msorair/bdkb40/case/keyboard_plate.stl

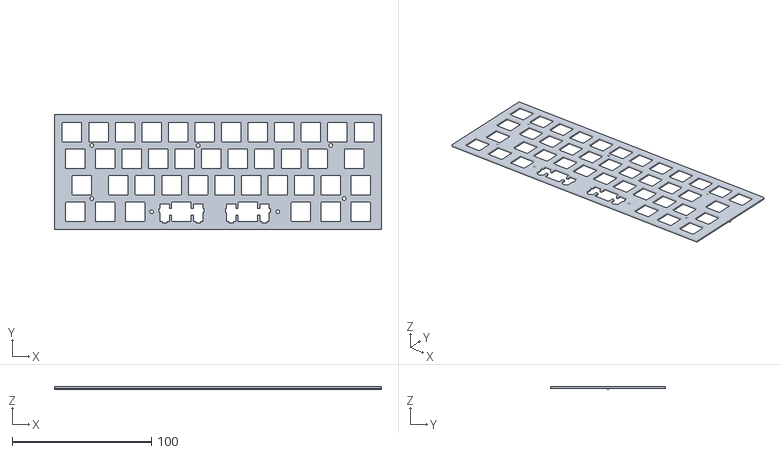
[picture p1: CAD file, 2026-01-17]
case/keyboard_plate.stl
234.6 x 82.2 x 2.50
