msorair/bdkb40/hardware/bdkb40.kicad_pcb

## KiCad design hardware/bdkb40.kicad_pcb (2026-03-20)

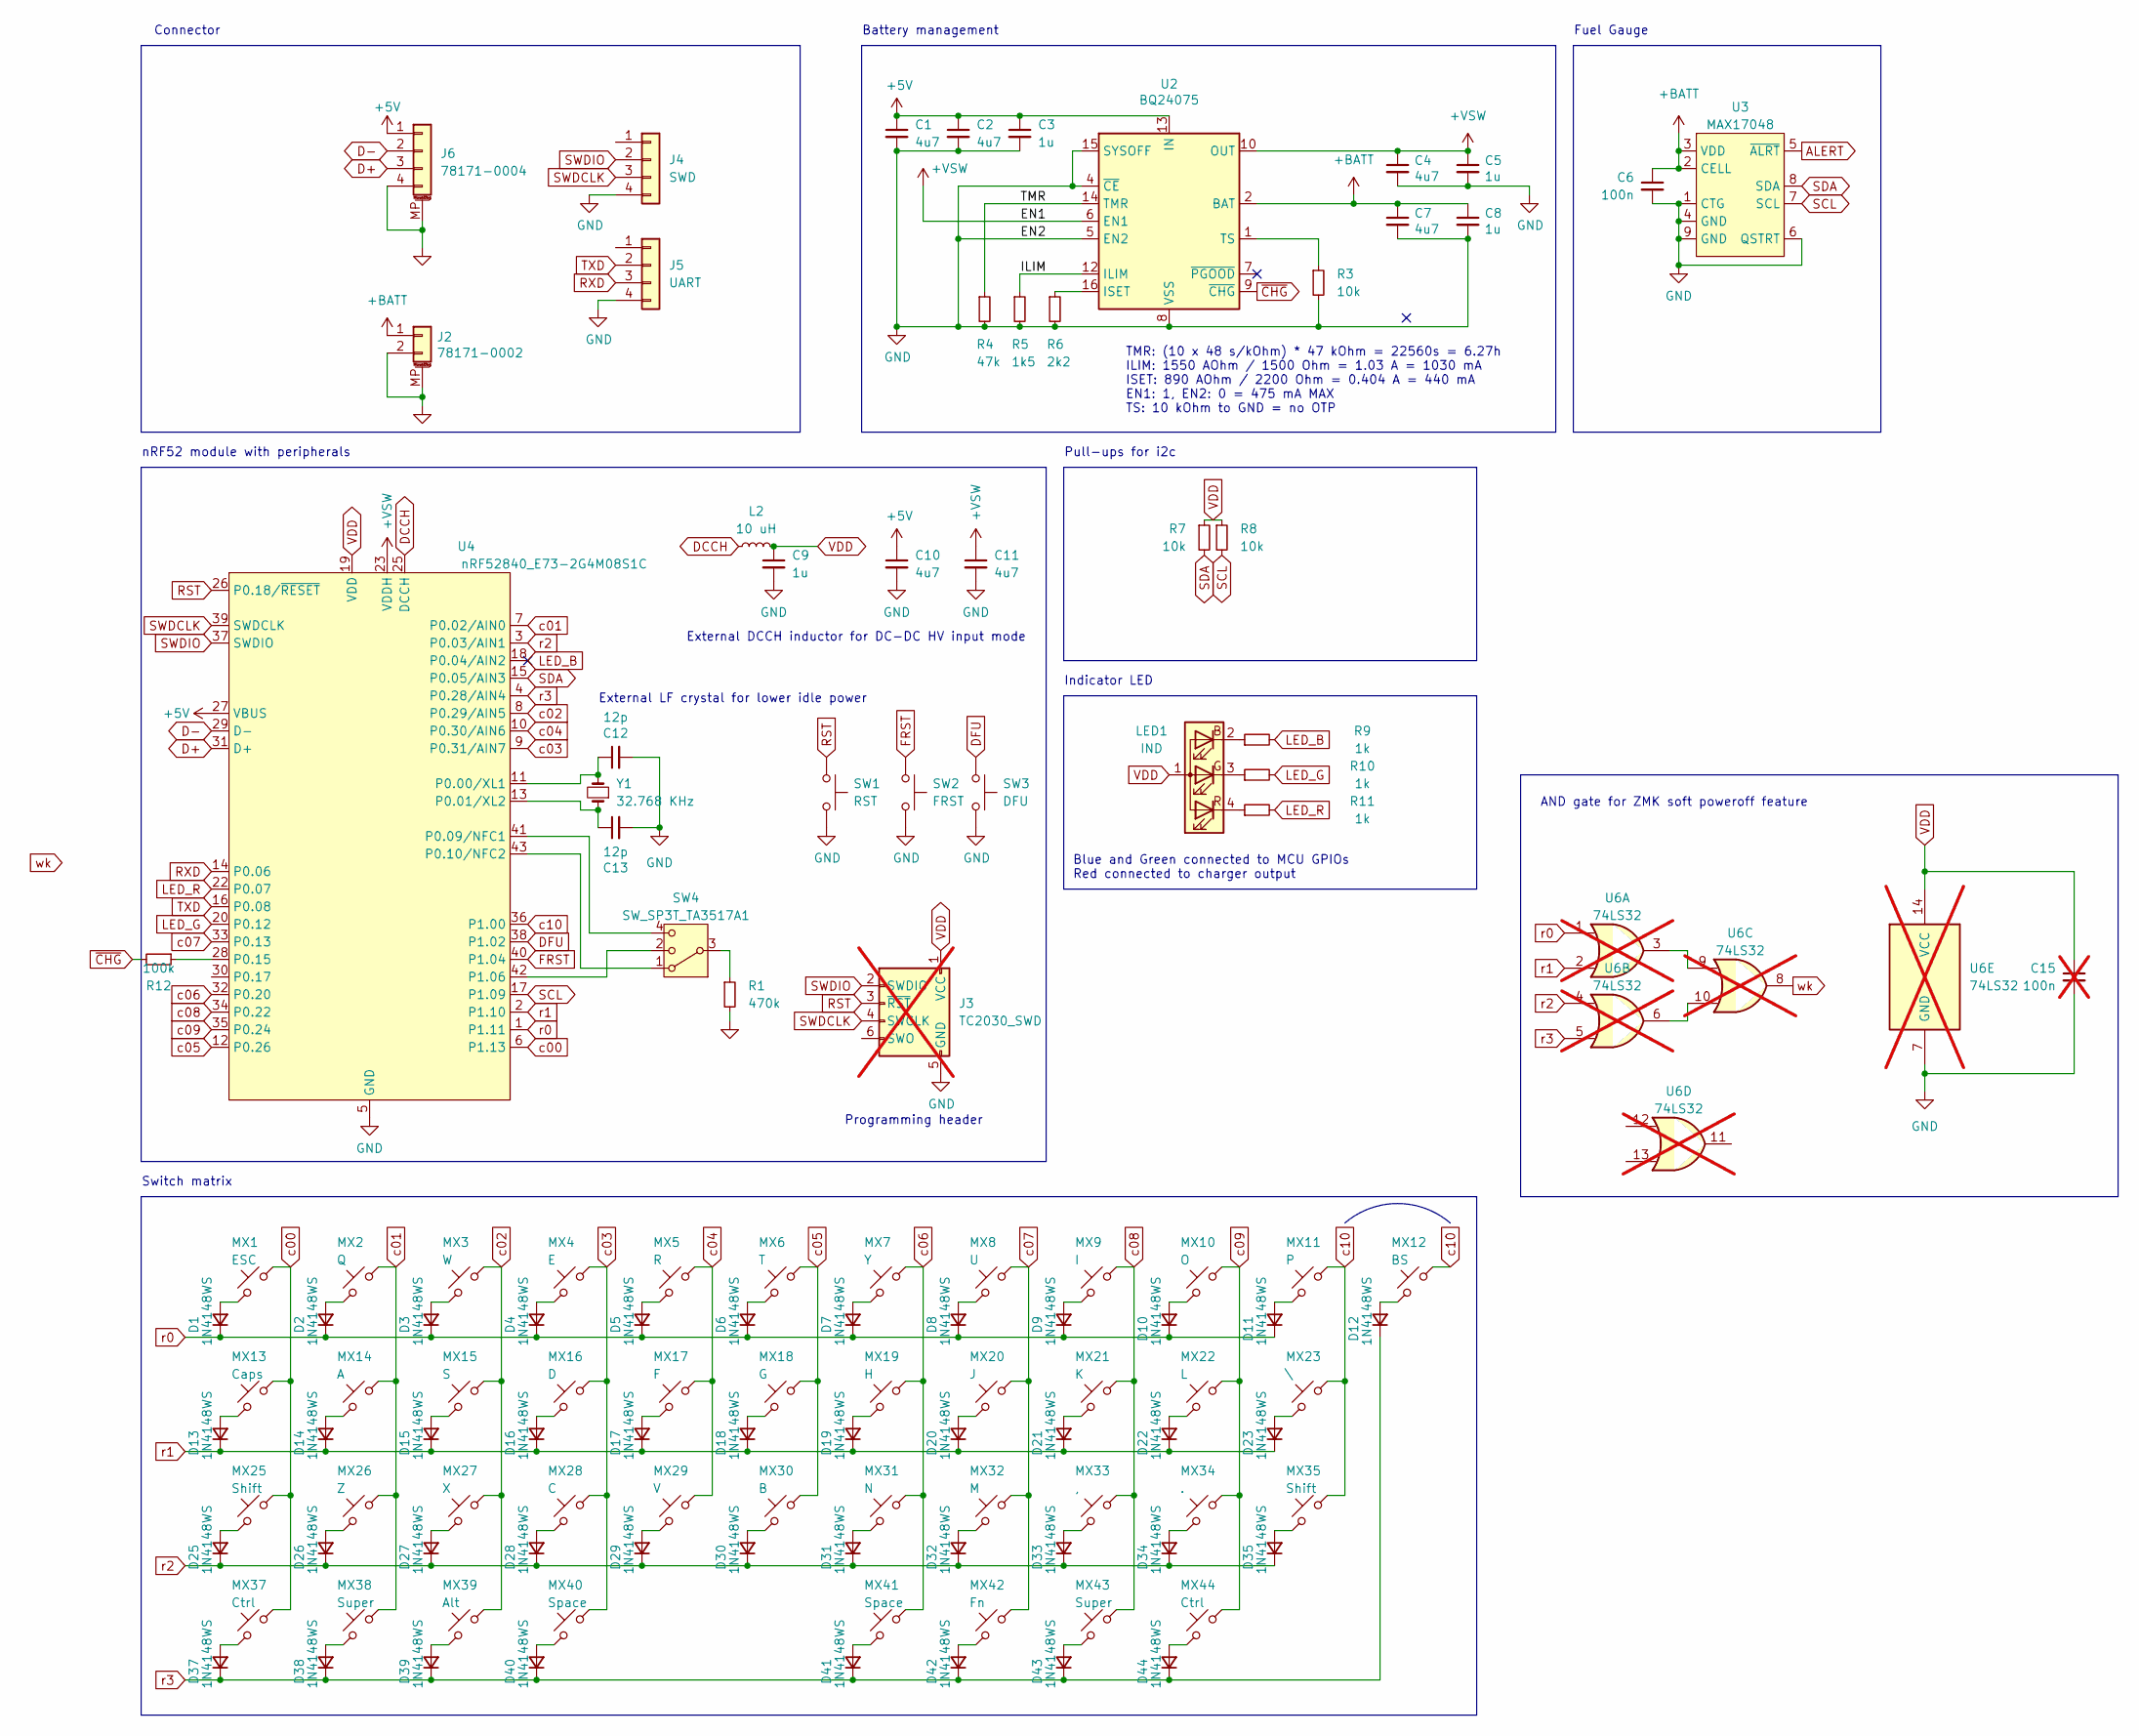
[picture p2: schematic bdkb40.kicad_sch]

Parts:
C1, C2, C4, C7, C10, C11: 4u7; C_0402_1005Metric; LCSC C23733
C3, C5, C8, C9: 1u; C_0402_1005Metric; LCSC C52923
C6: 100n; C_0402_1005Metric; LCSC C307331
C12, C13: 12p; C_0402_1005Metric; LCSC C1547
C15: 100n; C_0402_1005Metric; LCSC C307331; not fitted
D1, D2, D3, D4, D5, D6, D7, D8, D9, D10, D11, D12, D13, D14, D15, D16, D17, D18, D19, D20, D21, D22, D23, D25, D26, D27, D28, D29, D30, D31, D32, D33, D34, D35, D37, D38, D39, D40, D41, D42, D43, D44: 1N4148WS; D_SOD-323; LCSC C2128
J2: 78171-0002; Molex_Pico-EZmate_78171-0002_1x02-1MP_P1.20mm_Vertical; LCSC C505023
J3: TC2030_SWD; CON_TC2030_outlined; not fitted
J4: SWD; PinHeader_1x04_P2.54mm_Vertical
J5: UART; PinHeader_1x04_P2.54mm_Vertical
J6: 78171-0004; Molex_Pico-EZmate_78171-0004_1x04-1MP_P1.20mm_Vertical; LCSC C588524
L2: 10 uH; L_0603_1608Metric; LCSC C92982
LED1: IND; LED_1206R; LCSC C2802677
MX1: ESC; SW_MX_HS_CPG151101S11_1u; LCSC C5184526
MX2: Q; SW_MX_HS_CPG151101S11_1u; LCSC C5184526
MX3: W; SW_MX_HS_CPG151101S11_1u; LCSC C5184526
MX4: E; SW_MX_HS_CPG151101S11_1u; LCSC C5184526
MX5: R; SW_MX_HS_CPG151101S11_1u; LCSC C5184526
MX6: T; SW_MX_HS_CPG151101S11_1u; LCSC C5184526
MX7: Y; SW_MX_HS_CPG151101S11_1u; LCSC C5184526
MX8: U; SW_MX_HS_CPG151101S11_1u; LCSC C5184526
MX9: I; SW_MX_HS_CPG151101S11_1u; LCSC C5184526
MX10: O; SW_MX_HS_CPG151101S11_1u; LCSC C5184526
MX11: P; SW_MX_HS_CPG151101S11_1u; LCSC C5184526
MX12: BS; SW_MX_HS_CPG151101S11_1u; LCSC C5184526
MX13: Caps; SW_MX_HS_CPG151101S11_1.25u; LCSC C5184526
MX14: A; SW_MX_HS_CPG151101S11_1u; LCSC C5184526
MX15: S; SW_MX_HS_CPG151101S11_1u; LCSC C5184526
MX16: D; SW_MX_HS_CPG151101S11_1u; LCSC C5184526
MX17: F; SW_MX_HS_CPG151101S11_1u; LCSC C5184526
MX18: G; SW_MX_HS_CPG151101S11_1u; LCSC C5184526
MX19: H; SW_MX_HS_CPG151101S11_1u; LCSC C5184526
MX20: J; SW_MX_HS_CPG151101S11_1u; LCSC C5184526
MX21: K; SW_MX_HS_CPG151101S11_1u; LCSC C5184526
MX22: L; SW_MX_HS_CPG151101S11_1u; LCSC C5184526
MX23: \; SW_MX_HS_CPG151101S11_1.75u; LCSC C5184526
MX25: Shift; SW_MX_HS_CPG151101S11_1.75u; LCSC C5184526
MX26: Z; SW_MX_HS_CPG151101S11_1u; LCSC C5184526
MX27: X; SW_MX_HS_CPG151101S11_1u; LCSC C5184526
MX28: C; SW_MX_HS_CPG151101S11_1u; LCSC C5184526
MX29: V; SW_MX_HS_CPG151101S11_1u; LCSC C5184526
MX30: B; SW_MX_HS_CPG151101S11_1u; LCSC C5184526
MX31: N; SW_MX_HS_CPG151101S11_1u; LCSC C5184526
MX32: M; SW_MX_HS_CPG151101S11_1u; LCSC C5184526
MX33: ,; SW_MX_HS_CPG151101S11_1u; LCSC C5184526
MX34: .; SW_MX_HS_CPG151101S11_1u; LCSC C5184526
MX35: Shift; SW_MX_HS_CPG151101S11_1.25u; LCSC C5184526
MX37, MX44: Ctrl; SW_MX_HS_CPG151101S11_1.25u; LCSC C5184526
MX38, MX43: Super; SW_MX_HS_CPG151101S11_1u; LCSC C5184526
MX39: Alt; SW_MX_HS_CPG151101S11_1.25u; LCSC C5184526
MX40: Space; SW_MX_HS_CPG151101S11_2.25u; LCSC C5184526
MX41: Space; SW_MX_HS_CPG151101S11_2.75u; LCSC C5184526
MX42: Fn; SW_MX_HS_CPG151101S11_1.25u; LCSC C5184526
R1: 470k; R_0402_1005Metric; LCSC C23164
R3: 10k; R_0402_1005Metric; LCSC C25197
R4: 47k; R_0402_1005Metric; LCSC C25792
R5: 1k5; R_0402_1005Metric; LCSC C25867
R6: 2k2; R_0402_1005Metric; LCSC C25879
R7, R8: 10k; R_0402_1005Metric; LCSC C25744
R9, R10, R11: 1k; R_0402_1005Metric; LCSC C11702
R12: 100k; R_0402_1005Metric; LCSC C25744
SW1: RST; SW_SPST_TS-1088-xR025; LCSC C720477
SW2: FRST; SW_SPST_TS-1088-xR025; LCSC C720477
SW3: DFU; SW_SPST_TS-1088-xR025; LCSC C720477
SW4: SW_SP3T_TA3517A1; SW_SP3T_PCM13; LCSC C514001
U2: BQ24075; VQFN-16-1EP_3x3mm_P0.5mm_EP1.6x1.6mm; LCSC C15464
U3: MAX17048; DFN-8-1EP_2x2mm_P0.5mm_EP0.7x1.3mm; LCSC C2682616
U4: nRF52840_E73-2G4M08S1C; LCSC C356849
U6: 74LS32; DIP-14_W7.62mm_SMDSocket_SmallPads; not fitted
Y1: 32.768 KHz; Crystal_SMD_2012-2Pin_2.0x1.2mm; LCSC C20148

Connections:
+5V: C1.1, C2.1, C3.1, C10.1, J6.1, U2.13 (IN), U4.27 (VBUS)
+BATT: C6.1, C7.1, C8.1, J2.1, U2.2 (BAT), U2.3 (BAT), U3.2 (CELL), U3.3 (VDD)
+VSW: C4.1, C5.1, C11.1, U2.6 (EN1), U2.10 (OUT), U2.11 (OUT), U4.23 (VDDH)
/ILIM: R5.1, U2.12 (ILIM)
/TMR: R4.1, U2.14 (TMR)
ALERT: U3.5 (~ALRT)
D+: J6.3, U4.31 (D+)
D-: J6.2, U4.29 (D-)
DCCH: L2.1, U4.25 (DCCH)
DFU: SW3.1, U4.38 (P1.02)
FRST: SW2.1, U4.40 (P1.04)
GND: C1.2, C2.2, C3.2, C4.2, C5.2, C6.2, C7.2, C8.2, C9.2, C10.2, C11.2, C12.2, C13.2, C15.2, J2.2, J2.MP (MountPin), J3.5 (GND), J4.4, J5.4, J6.4, J6.MP (MountPin), R1.2, R3.2, R4.2, R5.2, R6.2, SW1.2, SW2.2, SW3.2, U2.4 (~CE), U2.5 (EN2), U2.8 (VSS), U2.15 (SYSOFF), U2.17 (VSS), U3.1 (CTG), U3.4 (GND), U3.6 (QSTRT), U3.9 (GND), U4.5 (GND), U4.21 (GND), U4.24 (GND), U6.7 (GND)
LED_B: R9.2, U4.18 (P0.04/AIN2)
LED_G: R10.2, U4.20 (P0.12)
LED_R: R11.2, U4.22 (P0.07)
unnamed: D1.2 (A), MX1.1
unnamed: D2.2 (A), MX2.1
unnamed: D3.2 (A), MX3.1
unnamed: D4.2 (A), MX4.1
unnamed: D5.2 (A), MX5.1
unnamed: D6.2 (A), MX6.1
unnamed: D7.2 (A), MX7.1
unnamed: D8.2 (A), MX8.1
unnamed: D9.2 (A), MX9.1
unnamed: D10.2 (A), MX10.1
unnamed: D11.2 (A), MX11.1
unnamed: D12.2 (A), MX12.1
unnamed: D13.2 (A), MX13.1
unnamed: D14.2 (A), MX14.1
unnamed: D15.2 (A), MX15.1
unnamed: D16.2 (A), MX16.1
unnamed: D17.2 (A), MX17.1
unnamed: D18.2 (A), MX18.1
unnamed: D19.2 (A), MX19.1
unnamed: D20.2 (A), MX20.1
unnamed: D21.2 (A), MX21.1
unnamed: D22.2 (A), MX22.1
unnamed: D23.2 (A), MX23.1
unnamed: D25.2 (A), MX25.1
unnamed: D26.2 (A), MX26.1
unnamed: D27.2 (A), MX27.1
unnamed: D28.2 (A), MX28.1
unnamed: D29.2 (A), MX29.1
unnamed: D30.2 (A), MX30.1
unnamed: D31.2 (A), MX31.1
unnamed: D32.2 (A), MX32.1
unnamed: D33.2 (A), MX33.1
unnamed: D34.2 (A), MX34.1
unnamed: D35.2 (A), MX35.1
unnamed: D37.2 (A), MX37.1
unnamed: D38.2 (A), MX38.1
unnamed: D39.2 (A), MX39.1
unnamed: D40.2 (A), MX40.1
unnamed: D41.2 (A), MX41.1
unnamed: D42.2 (A), MX42.1
unnamed: D43.2 (A), MX43.1
unnamed: D44.2 (A), MX44.1
unnamed: LED1.2 (BK), R9.1
unnamed: LED1.3 (GK), R10.1
unnamed: LED1.4 (RK), R11.1
unnamed: R1.1, SW4.3
unnamed: R6.1, U2.16 (ISET)
unnamed: R3.1, U2.1 (TS)
unnamed: C12.1, U4.11 (P0.00/XL1), Y1.2
unnamed: C13.1, U4.13 (P0.01/XL2), Y1.1
unnamed: SW4.4, U4.41 (P0.09/NFC1)
unnamed: SW4.1, U4.43 (P0.10/NFC2)
unnamed: R12.1, U4.28 (P0.15)
unnamed: SW4.2, U4.42 (P1.06)
unnamed: U6.3, U6.9
unnamed: U6.6, U6.10
RST: J3.3 (~RST), SW1.1, U4.26 (P0.18/~RESET)
RXD: J5.3, U4.14 (P0.06)
SCL: R8.2, U3.7 (SCL), U4.17 (P1.09)
SDA: R7.2, U3.8 (SDA), U4.15 (P0.05/AIN3)
SWDCLK: J3.4 (SWCLK), J4.3, U4.39 (SWDCLK)
SWDIO: J3.2 (SWDIO), J4.2, U4.37 (SWDIO)
TXD: J5.2, U4.16 (P0.08)
VDD: C9.1, C15.1, J3.1 (VCC), L2.2, LED1.1 (A), R7.1, R8.1, U4.19 (VDD), U6.14 (VCC)
c00: MX1.2, MX13.2, MX25.2, MX37.2, U4.6 (P1.13)
c01: MX2.2, MX14.2, MX26.2, MX38.2, U4.7 (P0.02/AIN0)
c02: MX3.2, MX15.2, MX27.2, MX39.2, U4.8 (P0.29/AIN5)
c03: MX4.2, MX16.2, MX28.2, MX40.2, U4.9 (P0.31/AIN7)
c04: MX5.2, MX17.2, MX29.2, U4.10 (P0.30/AIN6)
c05: MX6.2, MX18.2, MX30.2, U4.12 (P0.26)
c06: MX7.2, MX19.2, MX31.2, MX41.2, U4.32 (P0.20)
c07: MX8.2, MX20.2, MX32.2, MX42.2, U4.33 (P0.13)
c08: MX9.2, MX21.2, MX33.2, MX43.2, U4.34 (P0.22)
c09: MX10.2, MX22.2, MX34.2, MX44.2, U4.35 (P0.24)
c10: MX11.2, MX12.2, MX23.2, MX35.2, U4.36 (P1.00)
r0: D1.1 (K), D2.1 (K), D3.1 (K), D4.1 (K), D5.1 (K), D6.1 (K), D7.1 (K), D8.1 (K), D9.1 (K), D10.1 (K), D11.1 (K), U4.1 (P1.11), U6.1
r1: D13.1 (K), D14.1 (K), D15.1 (K), D16.1 (K), D17.1 (K), D18.1 (K), D19.1 (K), D20.1 (K), D21.1 (K), D22.1 (K), D23.1 (K), U4.2 (P1.10), U6.2
r2: D25.1 (K), D26.1 (K), D27.1 (K), D28.1 (K), D29.1 (K), D30.1 (K), D31.1 (K), D32.1 (K), D33.1 (K), D34.1 (K), D35.1 (K), U4.3 (P0.03/AIN1), U6.4
r3: D12.1 (K), D37.1 (K), D38.1 (K), D39.1 (K), D40.1 (K), D41.1 (K), D42.1 (K), D43.1 (K), D44.1 (K), U4.4 (P0.28/AIN4), U6.5
~CHG: R12.2, U2.9 (~CHG)

Notes on the sheet:
AND gate for ZMK soft poweroff feature
Indicator LED
Pull-ups for i2c
External DCCH inductor for DC-DC HV input mode
Programming header
Blue and Green connected to MCU GPIOs Red connected to charger output
Connector
TMR: (10 x 48 s/kOhm) * 47 kOhm = 22560s = 6.27h ILIM: 1550 AOhm / 1500 Ohm = 1.03 A = 1030 mA ISET: 890 AOhm / 2200 Ohm = 0.404 A = 440 mA EN1: 1, EN2: 0 = 475 mA MAX TS: 10 kOhm to GND = no OTP
Switch matrix
Fuel Gauge
Battery management
nRF52 module with peripherals
External LF crystal for lower idle power

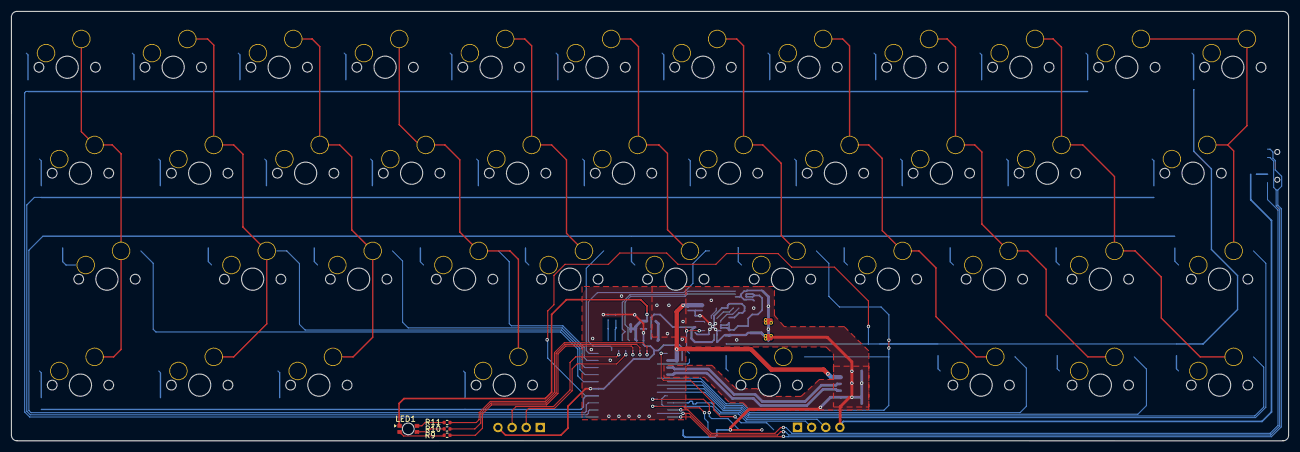
[picture p3: board bdkb40.kicad_pcb from above]

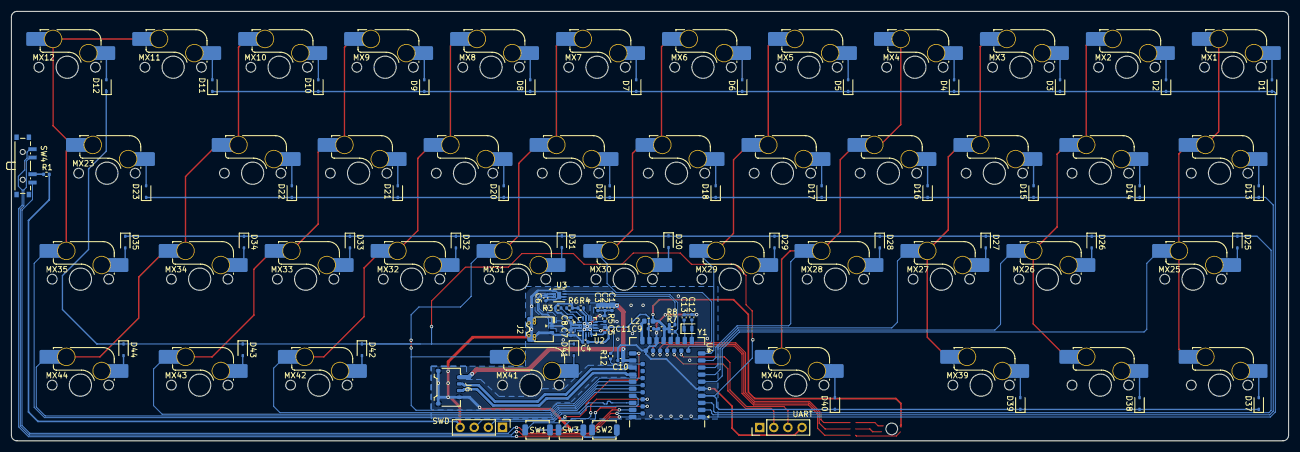
[picture p4: board bdkb40.kicad_pcb from below]

Board: 2 copper layers, 229.6 x 77.2 mm, 122 parts (118 on the bottom side), 92 nets.
