msorair/bdkb40/(commit log)

2025-12-21 pcb design move to hardware folder
    [bdkb40.csv, bdkb40.kicad_pcb, bdkb40.kicad_sch, bom.csv, designators.csv, positions.csv]
2025-12-21 Add support for generating plate and statilizer
2025-12-21 Add support for generating gasket plate
2026-01-04 support top mount case
2026-01-05 add fillet for top mount
2026-01-07 add heatset hole for top mount case
2026-01-07 update pcb
    [bdkb40.kicad_pcb]
2026-01-09 add bottom plate
2026-01-17 add rib for plate
2026-01-17 update plate
    [keyboard_plate.stl]
2026-01-17 update pcd
    [bdkb40.kicad_pcb]
2026-03-20 update fabrication info
    [bdkb40.kicad_pcb, bdkb40.kicad_sch]
